rjw57/buri/hardware/README.md

# Buri: a simple 6502-based computer

This is very much a work in progress repository. It contains schematics, notes,
etc. for a single-board 6502 computer I'm working on.

## Copying

See the [LICENSE](LICENSE.txt) file in the repository for copying information.
