rjw57/buri/hardware/cpu-board/README.md

# Búri CPU board

This board contains the CPU, RAM and ROM along with a UART. It is the smallest
"standalone" computer which is of actual use within the Búri system.
