rjw57/buri/docs/monitor-board.md

---
priority: 1
layout: page
title: Monitor Board
permalink: /hardware/monitor-board/
categories: hardware
excerpt: >
  The Monitor Board provides facilities for halting the processor, single
  stepping, single cycling and reading/writing from/to memory. It's a relatively
  simple bit of hardware driven by an Arduino.
---

<figure>
  The Búri monitor board implemented on a breadboard.
  <figcaption>The Búri monitor board implemented on a breadboard.</figcaption>
</figure>

TODO
