rjw57/buri/docs/_posts/2016-12-08-v3-uploaded.md

---
layout: post
title: "Version 3 uploaded"
date: 2016-12-08
categories: update
---

The old Búri repo did not reflect the current state of development. I've had a
chance to re-think the approach I was taking and now I've uploaded some details
on the new version.
