rjw57/buri/docs/img/bodge-1.jpg

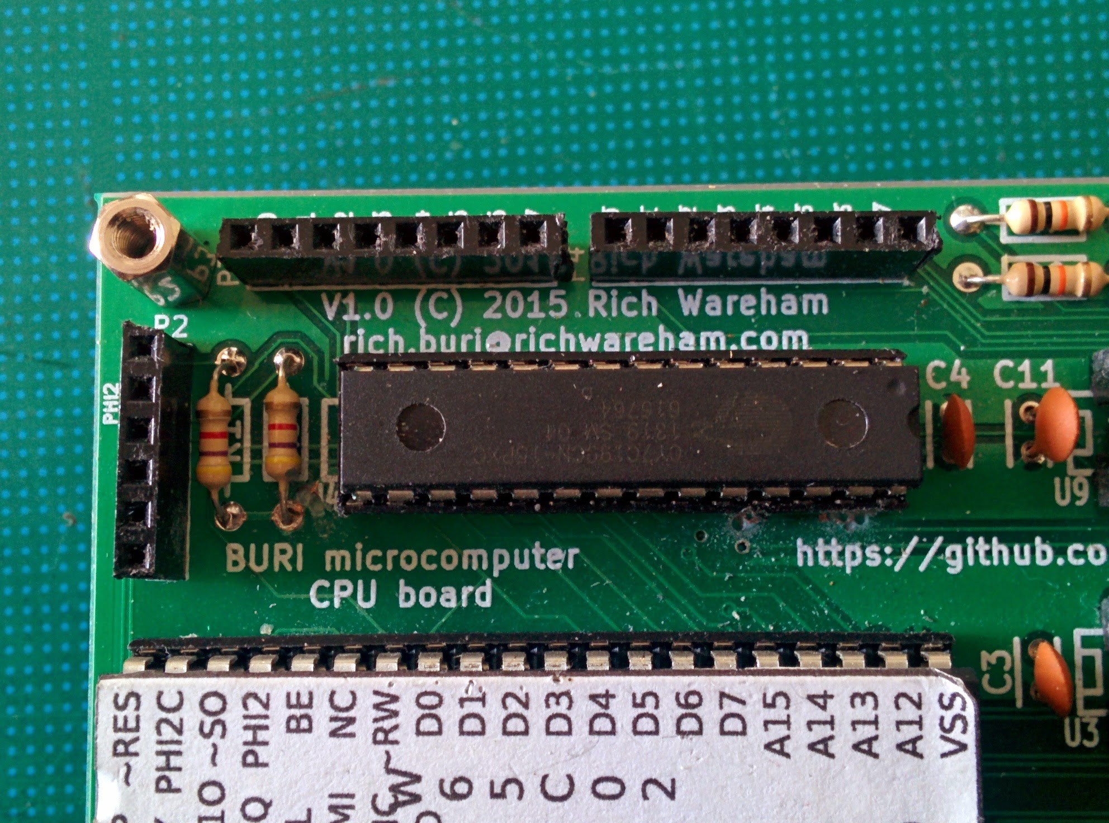
docs/img/bodge-1.jpg
