rjw57/buri/docs/img/bodge-2.jpg

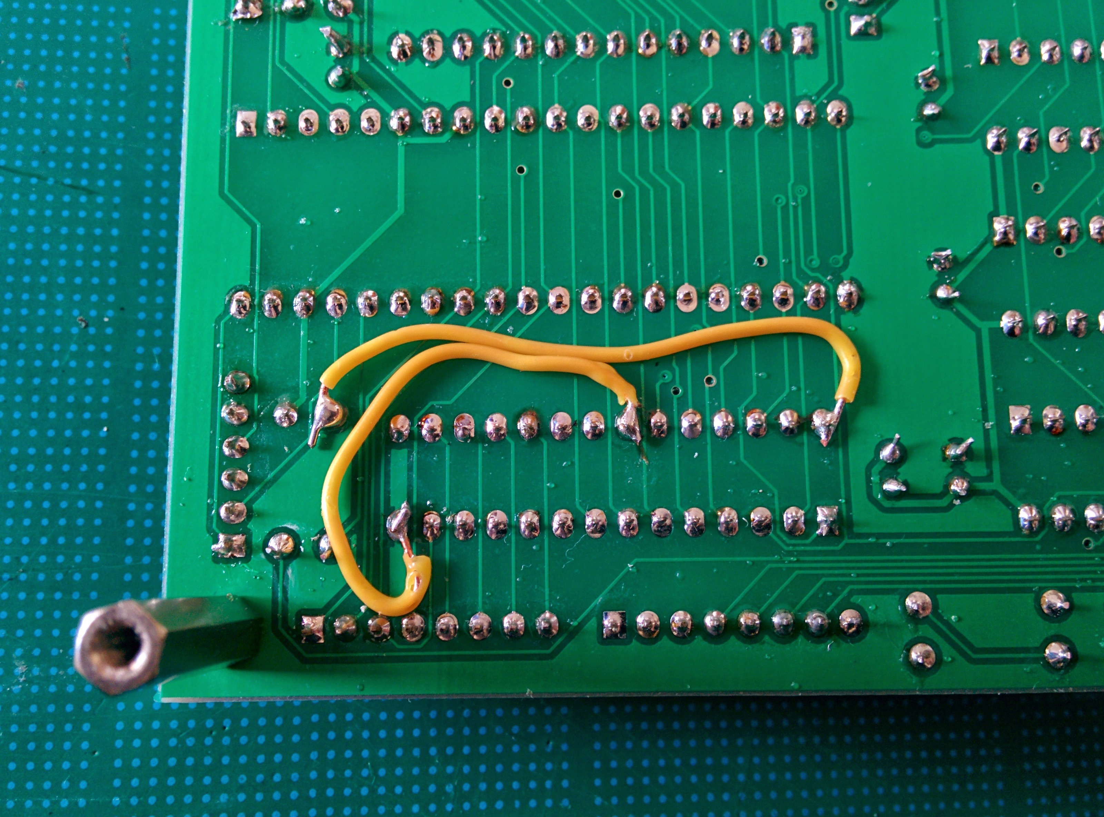
docs/img/bodge-2.jpg
