rjw57/buri/docs/img/cpu-board-3.jpg

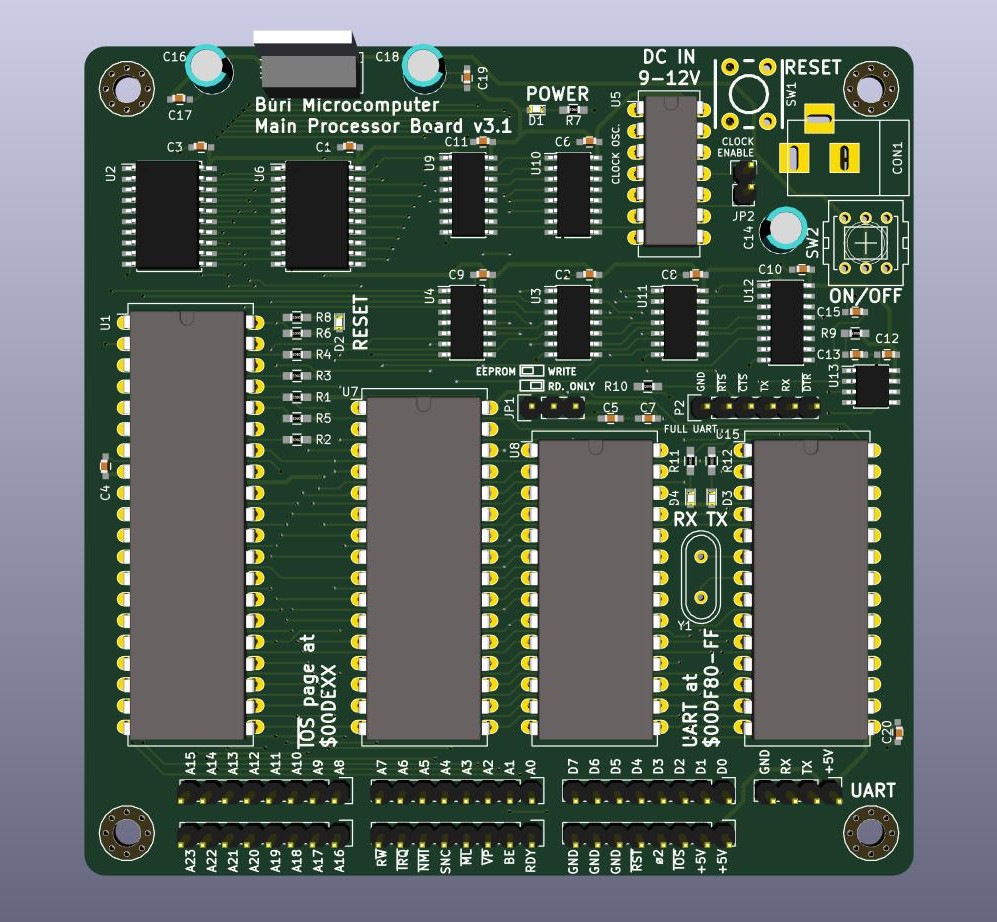
docs/img/cpu-board-3.jpg
