rjw57/buri/docs/img/cpu-board.jpg

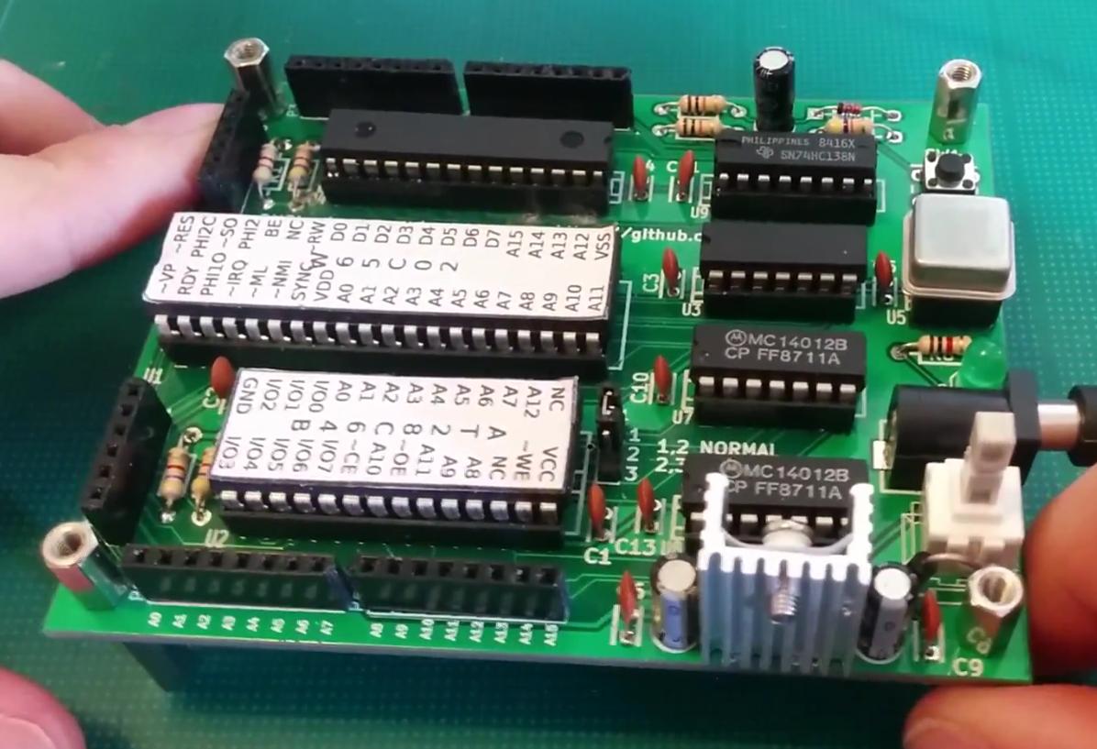
docs/img/cpu-board.jpg
