rjw57/buri/docs/img/lcd-bus-adapter.png

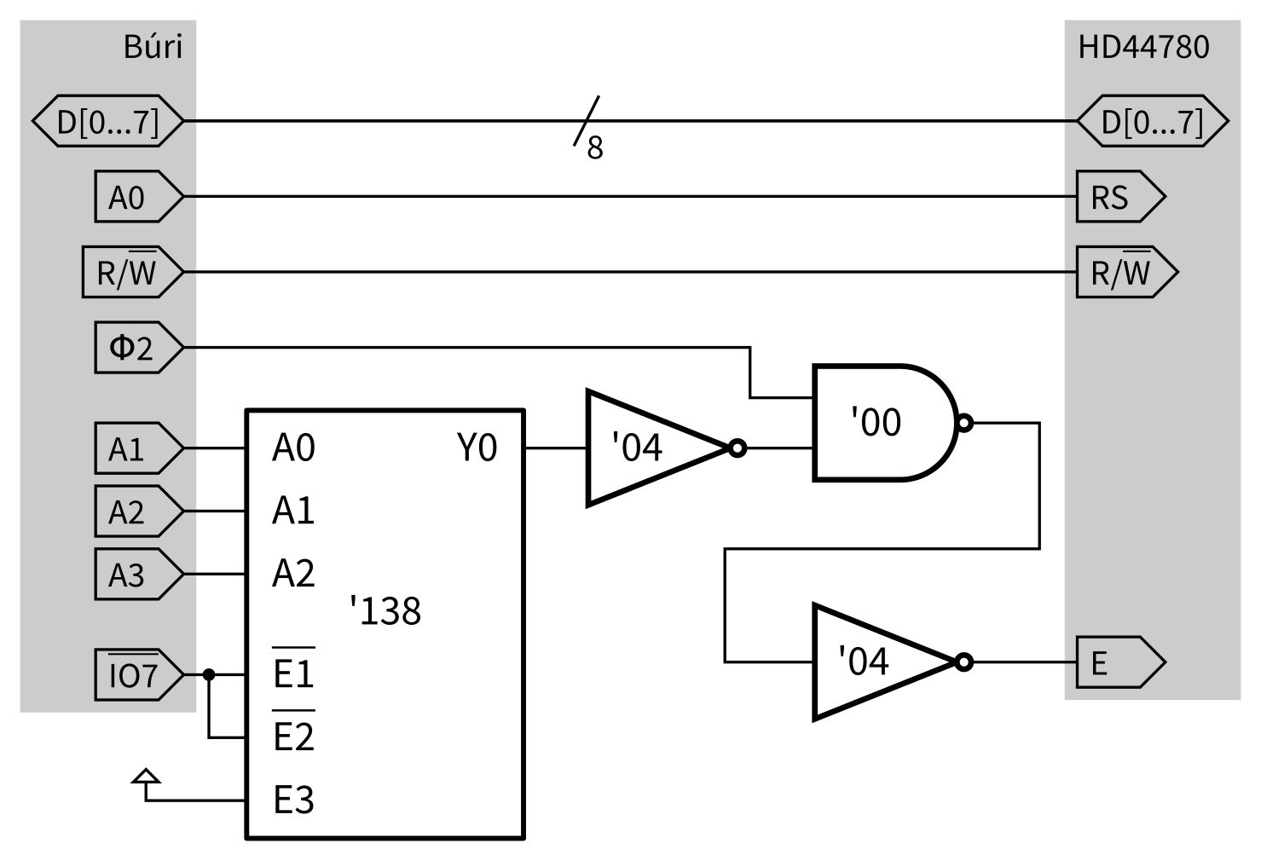
docs/img/lcd-bus-adapter.png
