rjw57/buri/docs/img/lcd-hello.jpg

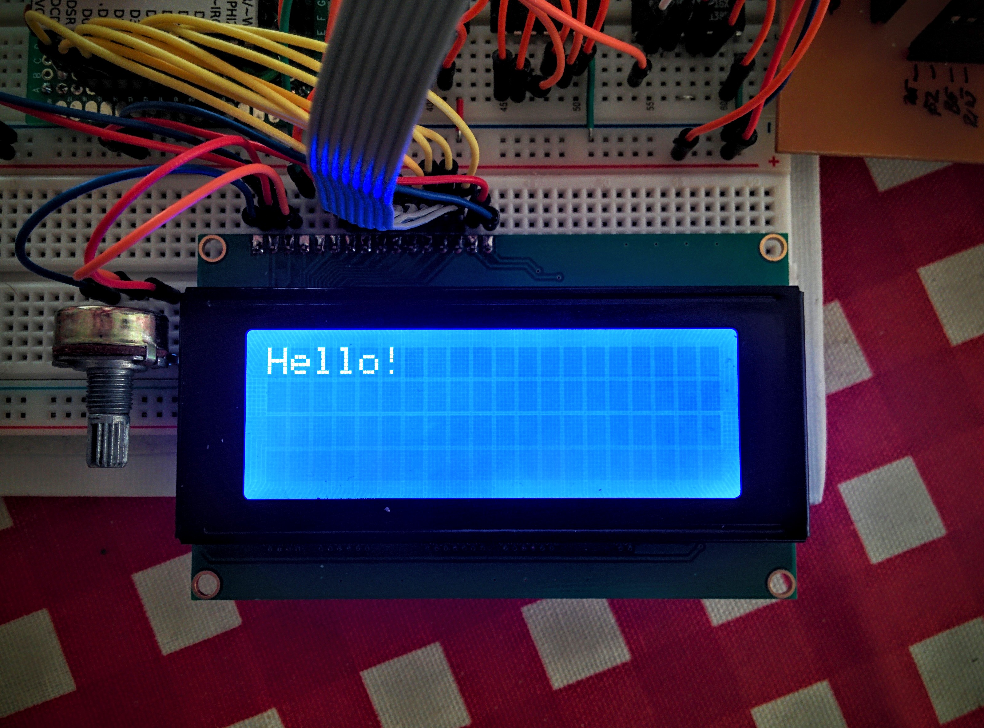
docs/img/lcd-hello.jpg
