rjw57/buri/docs/img/monitor-board.jpg

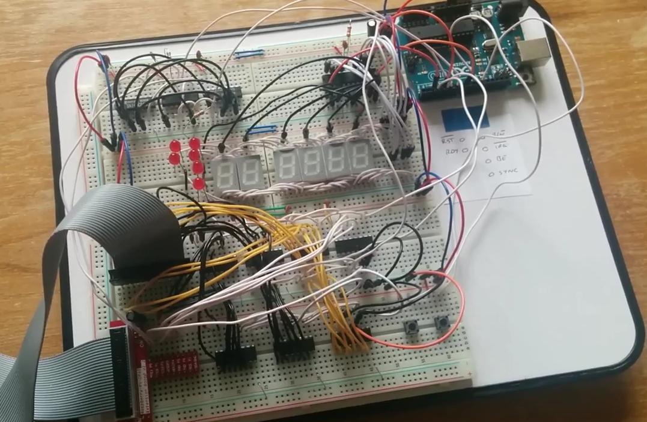
docs/img/monitor-board.jpg
