rjw57/buri/docs/img/serial-port-prototyping.jpg

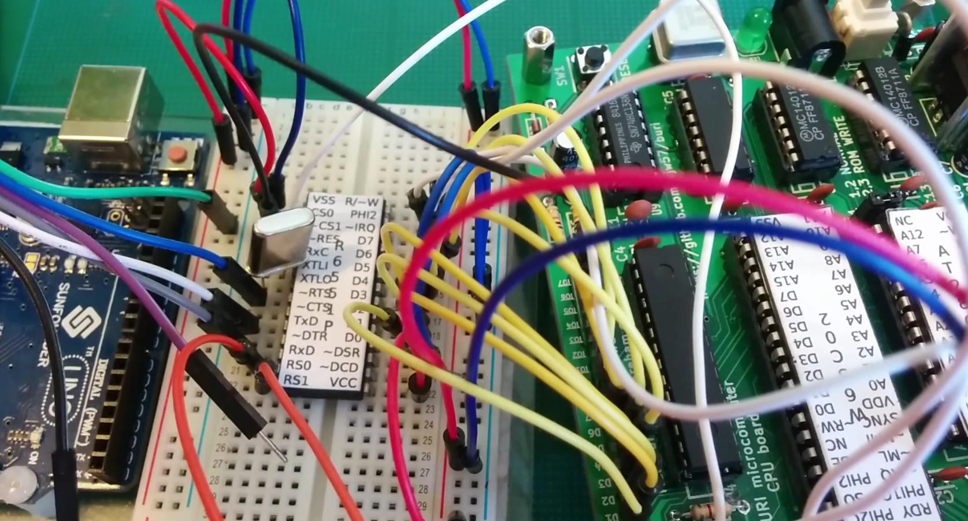
docs/img/serial-port-prototyping.jpg
