rjw57/buri/(threads)

Thread 1 (2016-02-04):

Broken link to sim directory

BigEd, 2016-02-04:
Is https://github.com/rjw57/buri-simulator-python the current simulator? If so, perhaps update the link in the README here?

rjw57, 2016-02-04:
Ah! Thanks, yes. The docs have gotten a bit out of sync.

Fixed in 2caa4544a1e4683c265053cc5f9a26e9466787b4

Closed 2016-02-04.
