rjw57/buri/hardware/cpu-board/plots/cpu-board.pdf

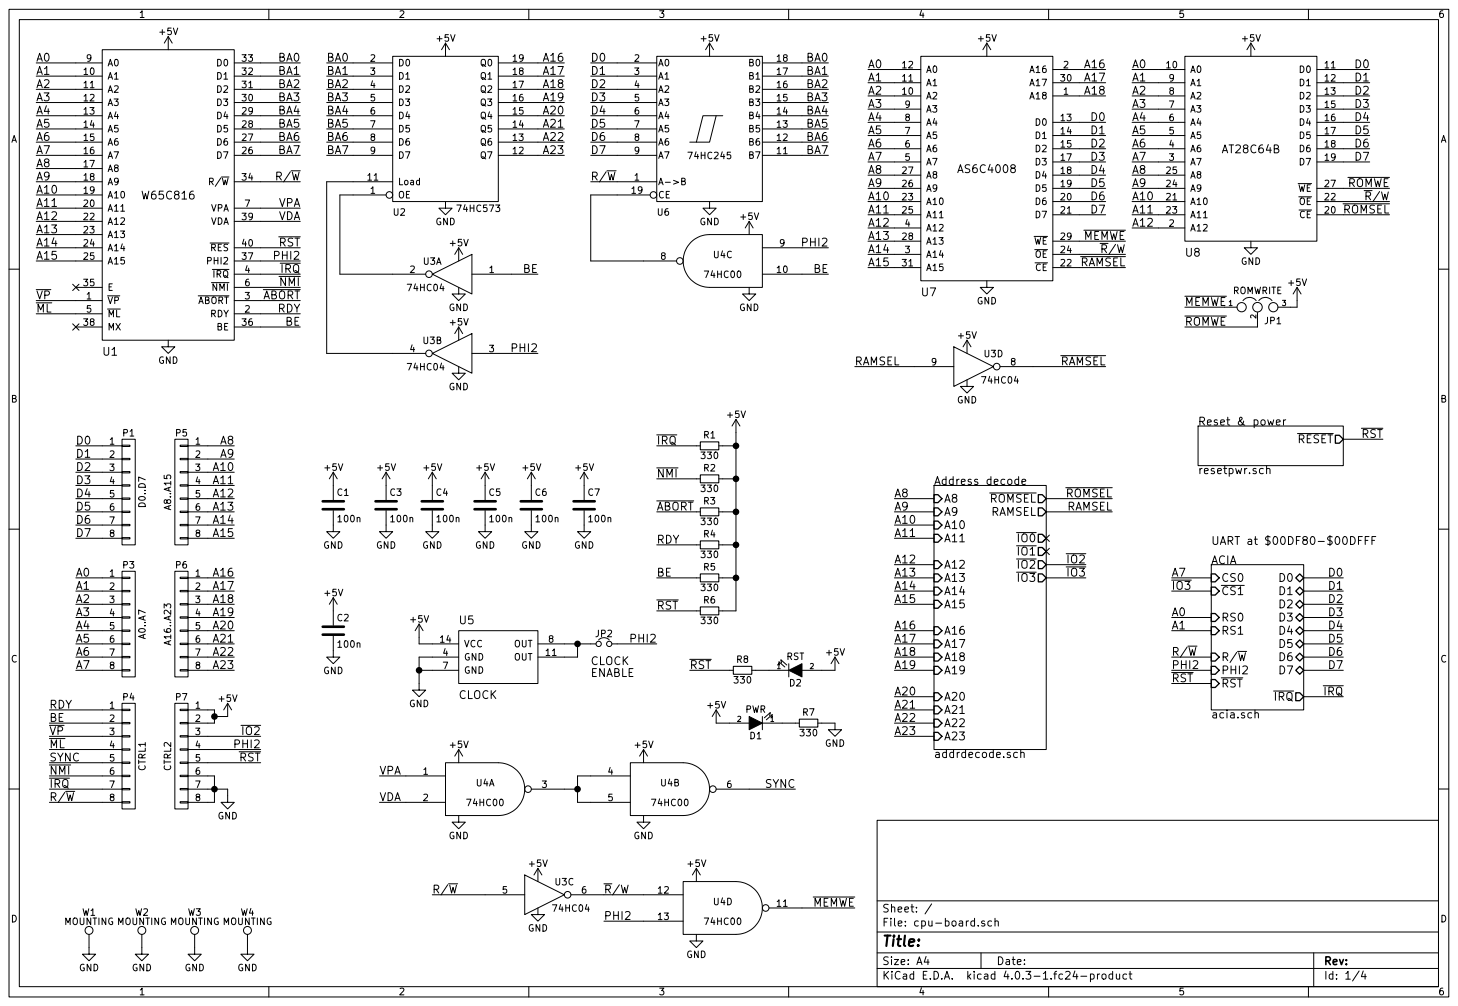
[picture p16: page 1]

UART at $00DF80-$00DFFF Address decode

File: cpu-board.sch Sheet: /
Id: 1/4 Title:

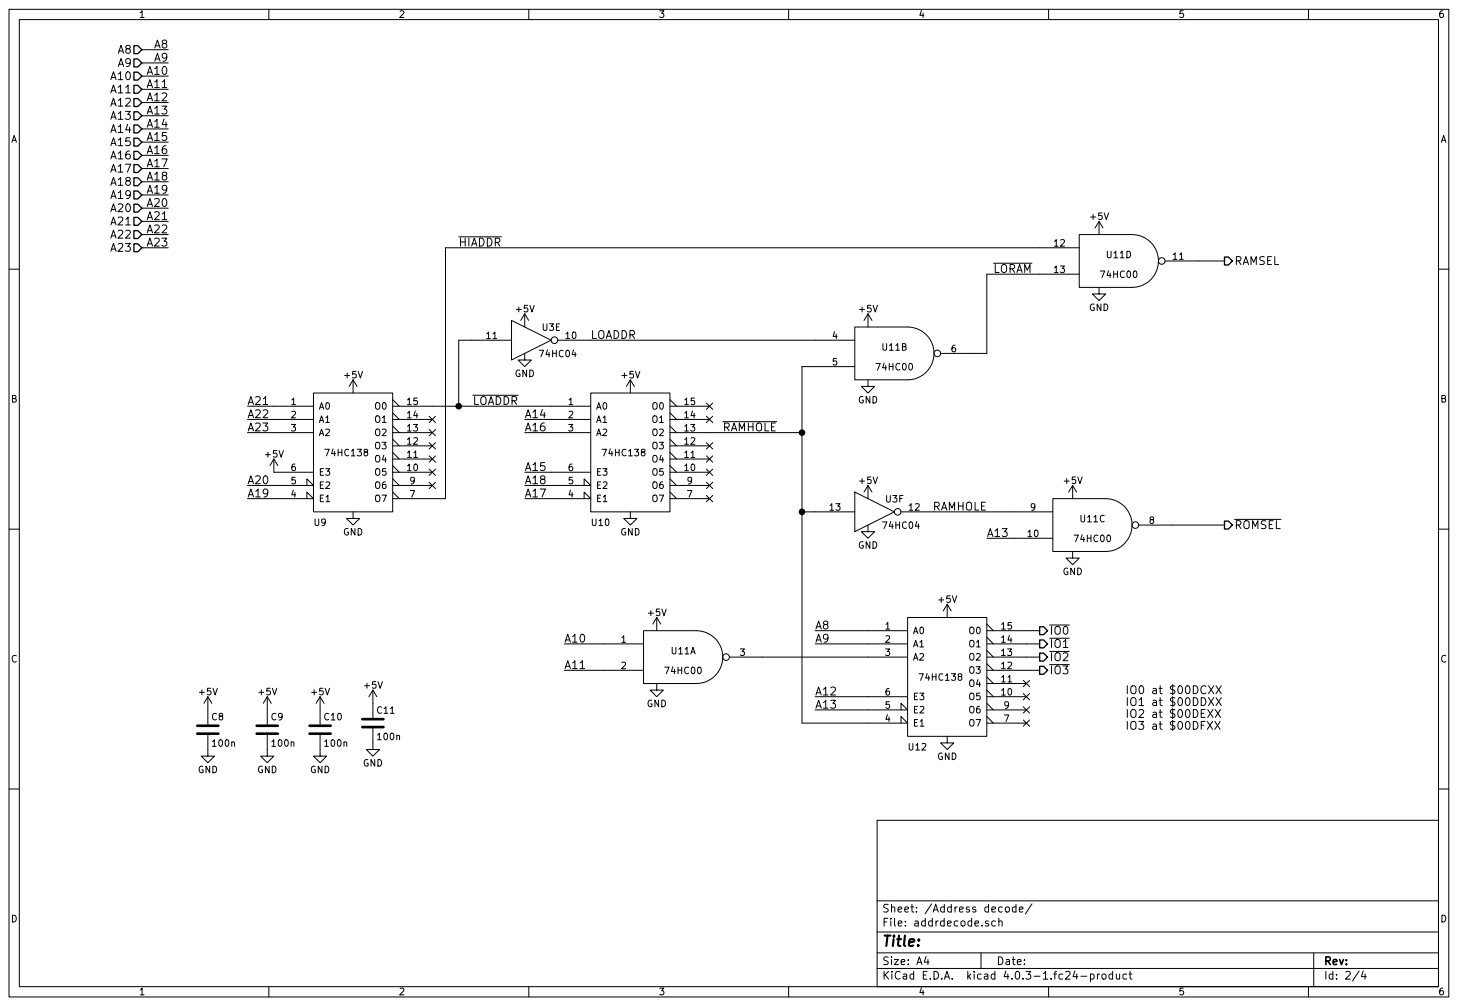
[picture p17: page 2]

Id: 2/4 Title: File: addrdecode.sch Sheet: /Address decode/

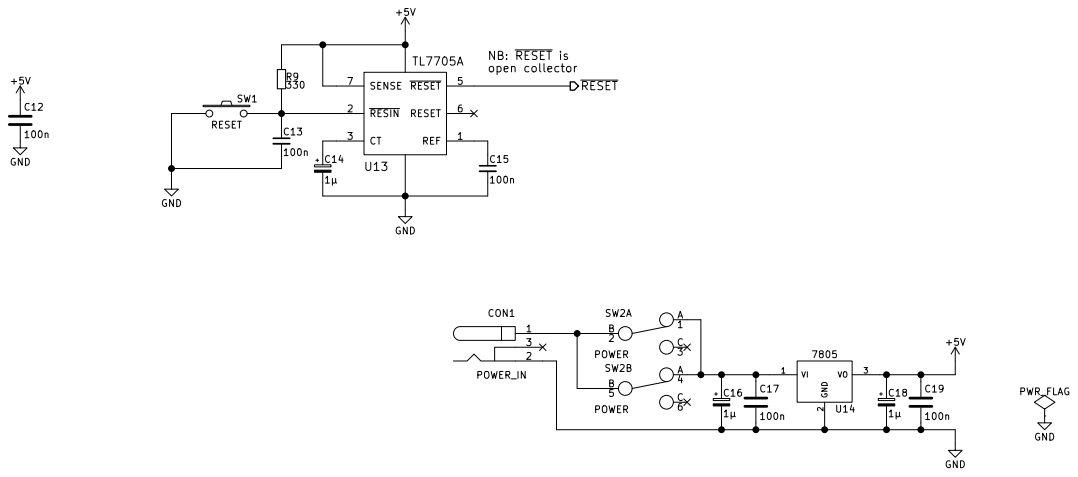
[picture p18: page 3]

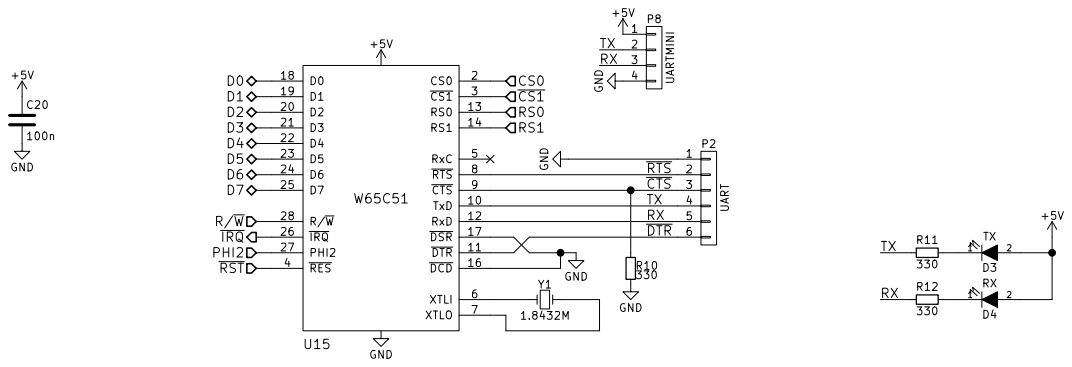
[picture p19: page 4]

Id: 4/4 Title: File: acia.sch Sheet: /ACIA/ GND
