rjw57/buri/hardware/combined/combined.kicad_pcb

## KiCad design hardware/combined/combined.kicad_pcb (2017-01-06)

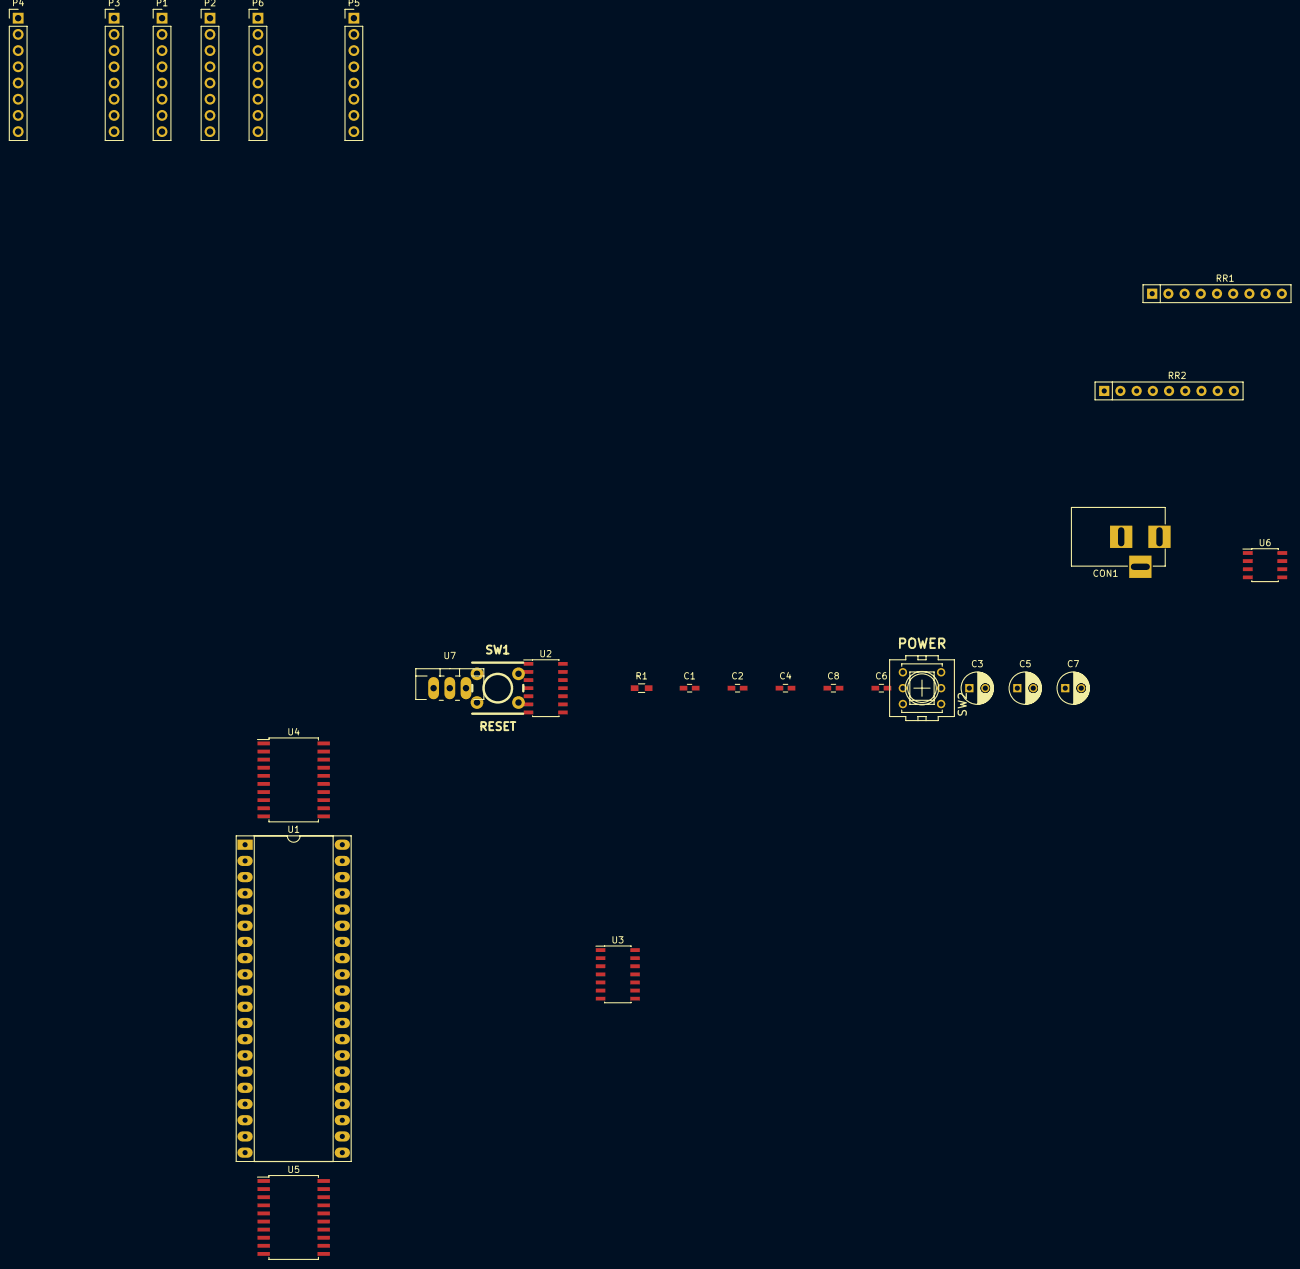
[picture p20: board combined.kicad_pcb from above]

Board: 2 copper layers, 27 parts (0 on the bottom side), 60 nets, no tracks yet.

Parts:
C1, C2, C4, C6, C8: 100n; C_0603_HandSoldering
C3, C5, C7: 1µ; C_Radial_D5_L6_P2.5
CON1: POWER_IN; BARREL_JACK
P1: A0..A7; Pin_Header_Straight_1x08_Pitch2.54mm
P2: A8..A15; Pin_Header_Straight_1x08_Pitch2.54mm
P3: A16..A23; Pin_Header_Straight_1x08_Pitch2.54mm
P4: D0..D7; Pin_Header_Straight_1x08_Pitch2.54mm
P5: CTRL1; Pin_Header_Straight_1x08_Pitch2.54mm
P6: CTRL2; Pin_Header_Straight_1x08_Pitch2.54mm
R1: 330; R_0603_HandSoldering
RR1, RR2: RR8; Resistor_Array_SIP9
SW1: RESET; SW_M6_PTH
SW2: POWER; switch-misc-PVA2R
U1: W65C816; DIP-40_W15.24mm_Socket_LongPads
U2: 74HC04; SOIC-14_3.9x8.7mm_Pitch1.27mm
U3: 74HC00; SOIC-14_3.9x8.7mm_Pitch1.27mm
U4: 74HC245; SOIC-20W_7.5x12.8mm_Pitch1.27mm
U5: 74HC573; SOIC-20W_7.5x12.8mm_Pitch1.27mm
U6: TL7705A; SOIC-8_3.9x4.9mm_Pitch1.27mm
U7: 7805; TO-220_Neutral123_Vertical_LargePads

Connections:
+5V: C1.1, C7.1, C8.1, P6.1, P6.2, R1.1, RR2.1, U1.8, U2.14, U3.14, U4.20, U5.20, U6.7, U6.8, U7.3
/BE: P5.2, RR2.6, U1.36, U2.3, U3.2
/CPU/~ABORT: RR2.5, U1.3
/PHI2: P6.4, U1.37, U2.1, U3.1
/R/~W: P5.8, U1.34, U4.1
/RDY: P5.1, RR2.7, U1.2
/~IRQ: P5.7, RR2.3, U1.4
/~ML: P5.4, U1.5
/~NMI: P5.6, RR2.4, U1.6
/~RST: P6.5, RR2.2, U1.40, U6.5
/~VP: P5.3, U1.1
A0: P1.1, U1.9
A1: P1.2, U1.10
A2: P1.3, U1.11
A3: P1.4, U1.12
A4: P1.5, U1.13
A5: P1.6, U1.14
A6: P1.7, U1.15
A7: P1.8, U1.16
A8: P2.1, U1.17
A9: P2.2, U1.18
A10: P2.3, U1.19
A11: P2.4, U1.20
A12: P2.5, U1.22
A13: P2.6, U1.23
A14: P2.7, U1.24
A15: P2.8, U1.25
A16: P3.1, U5.19
A17: P3.2, U5.18
A18: P3.3, U5.17
A19: P3.4, U5.16
A20: P3.5, U5.15
A21: P3.6, U5.14
A22: P3.7, U5.13
A23: P3.8, U5.12
D0: P4.1, RR1.2, U4.2
D1: P4.2, RR1.3, U4.3
D2: P4.3, RR1.4, U4.4
D3: P4.4, RR1.5, U4.5
D4: P4.5, RR1.6, U4.6
D5: P4.6, RR1.7, U4.7
D6: P4.7, RR1.8, U4.8
D7: P4.8, RR1.9, U4.9
GND: C1.2, C2.2, C3.2, C4.2, C5.2, C6.2, C7.2, C8.2, CON1.2, P5.5, P6.6, P6.7, P6.8, RR1.1, SW1.1, U1.21, U2.7, U3.7, U4.10, U5.10, U6.4, U7.2
unnamed: C2.1, R1.2, SW1.2, U6.2
unnamed: C3.1, U6.3
unnamed: C4.1, U6.1
unnamed: C5.1, C6.1, SW2.1, SW2.4, U7.1
unnamed: CON1.1, SW2.2, SW2.5
unnamed: U1.26, U4.11, U5.9
unnamed: U1.27, U4.12, U5.8
unnamed: U1.28, U4.13, U5.7
unnamed: U1.29, U4.14, U5.6
unnamed: U1.30, U4.15, U5.5
unnamed: U1.31, U4.16, U5.4
unnamed: U1.32, U4.17, U5.3
unnamed: U1.33, U4.18, U5.2
unnamed: U2.2, U5.11
unnamed: U2.4, U5.1
unnamed: U3.3, U4.19
