rjw57/buri/hardware/av-board/av-board.kicad_pcb

## KiCad design hardware/av-board/av-board.kicad_pcb (2016-12-16)

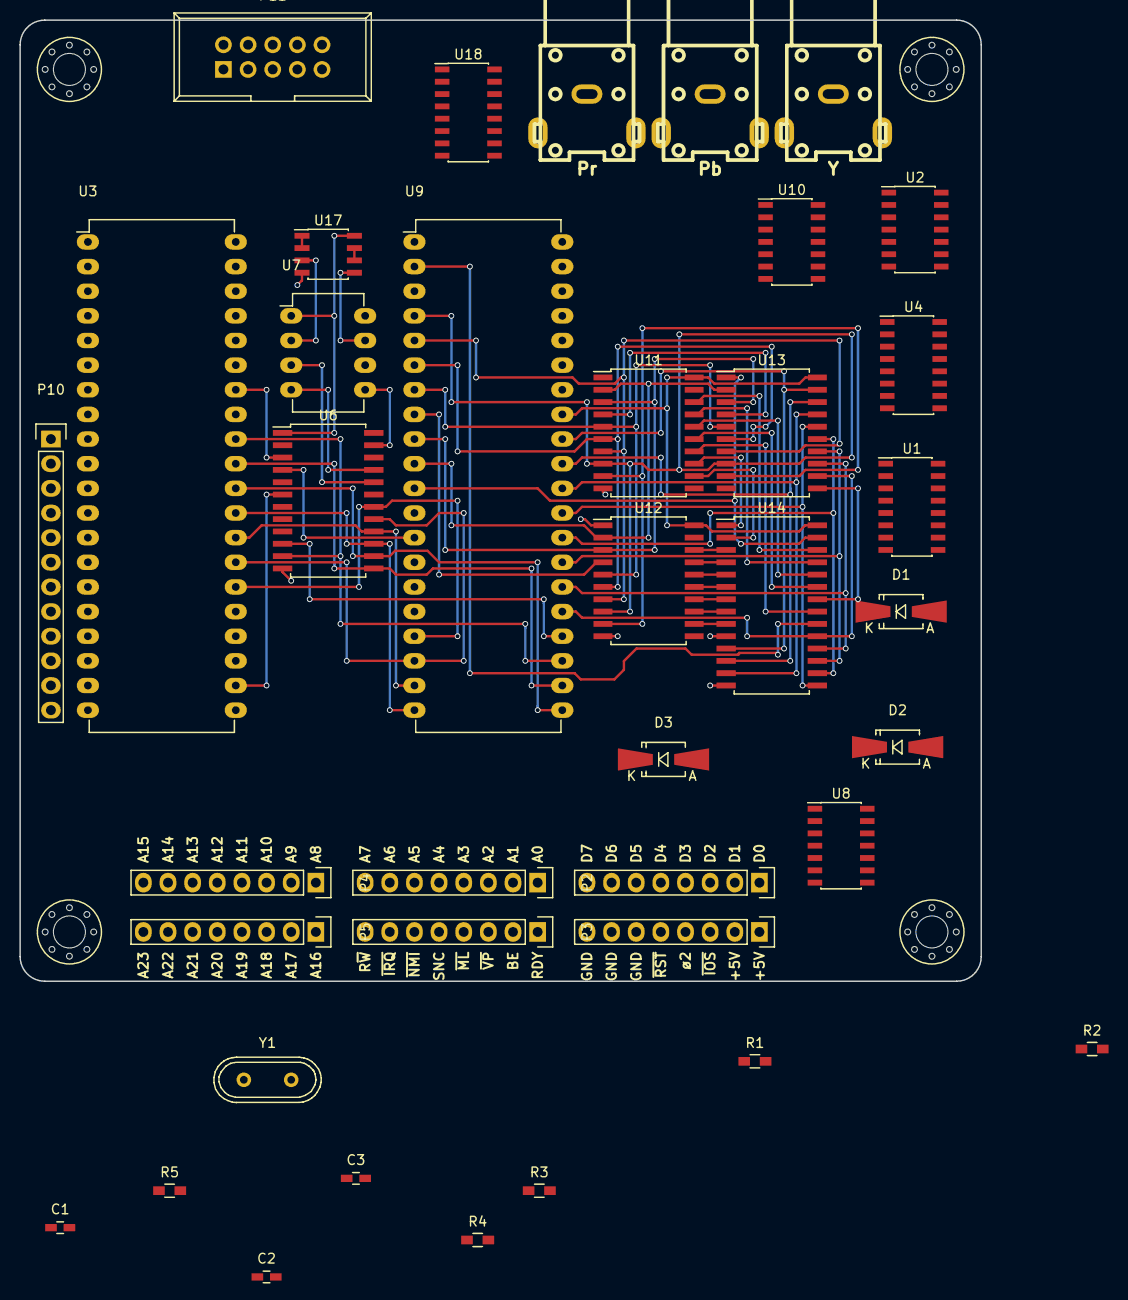
[picture p21: board av-board.kicad_pcb from above]

Board: 2 copper layers, 99.1 x 99.1 mm, 42 parts (0 on the bottom side), 98 nets.

Parts:
C1, C2: 27pF; C_0603_HandSoldering
C3: 100n; C_0603_HandSoldering
D1, D2, D3: D_Small; SMA-SMB_Universal_Handsoldering
P1: D0..D7; Pin_Header_Straight_1x08
P2: A0..A7; Pin_Header_Straight_1x08
P3: CTRL1; Pin_Header_Straight_1x08
P4: A8..A15; Pin_Header_Straight_1x08
P5: A16..A23; Pin_Header_Straight_1x08
P6: CTRL2; Pin_Header_Straight_1x08
P7: Pr; rca_black
P8: Y; rca_black
P9: Pb; rca_black
P10: PARALLEL; Pin_Header_Straight_1x12
P11: KEYBOARD; IDC_Header_Straight_10pins
R1, R2, R3: 330; R_0603_HandSoldering
R4, R5: 1K; R_0603_HandSoldering
U1, U4, U18: 74HC138; SOIC-16_3.9x9.9mm_Pitch1.27mm
U2, U10: 74HC00; SOIC-14_3.9x8.7mm_Pitch1.27mm
U3: WD65C22; DIP-40_W15.24mm_LongPads
U6: YM3812; SOIC-24W_7.5x15.4mm_Pitch1.27mm
U7: YM3014; DIP-8_W7.62mm_LongPads
U8: 74HC04; SOIC-14_3.9x8.7mm_Pitch1.27mm
U9: TMS9929; DIP-40_W15.24mm_LongPads
U11, U12, U13: 74LS574; SOIC-20W_7.5x12.8mm_Pitch1.27mm
U14: CY62256; SOIC-28W_7.5x17.9mm_Pitch1.27mm
U17: TL072; SOIC-8_3.9x4.9mm_Pitch1.27mm
W1, W2, W3, W4: MOUNTING; M3_MOUNT
Y1: 21.48MHz; Crystal_HC49-U_Vertical

Connections:
+5V: P6.1, P6.2, P10.1, P11.2, U1.6, U1.16, U2.14, U3.20, U3.24, U4.16, U6.1, U7.1, U8.14, U9.33, U10.14, U11.20, U12.20, U13.20, U14.28, U17.8, U18.6, U18.16
/A0: P2.1, U3.38, U6.4, U9.13
/A1: P2.2, U3.37
/A2: P2.3, U3.36, U4.1
/A3: P2.4, U3.35, U4.2
/A4: P2.5, U1.1, U4.3
/A5: P2.6, U1.2, U4.6
/A6: P2.7, U1.3, U2.1
/A7: P2.8, U1.5, U2.2
/D0: P1.1, U3.33, U6.10, U9.24
/D1: P1.2, U3.32, U6.11, U9.23
/D2: P1.3, U3.31, U6.13, U9.22
/D3: P1.4, U3.30, U6.14, U9.21
/D4: P1.5, U3.29, U6.15, U9.20
/D5: P1.6, U3.28, U6.16, U9.19
/D6: P1.7, U3.27, U6.17, U9.18
/D7: P1.8, U3.26, U6.18, U9.17
/PHI2: P6.4, U3.25
/R/~W: P3.8, U3.22, U6.6, U10.12
/SPICLK: P11.3, U3.2
/SPIMISO: P11.1, U3.9
/SPIMOSI: P11.4, U3.3
/Sound/OUT: U17.1, U17.2
/Video/COL: U8.8, U12.11
/Video/SEL: U10.1, U10.13
/Video/VD0: U9.32, U13.19, U14.11
/Video/VD1: U9.31, U13.18, U14.12
/Video/VD2: U9.30, U13.17, U14.13
/Video/VD3: U9.29, U13.16, U14.15
/Video/VD4: U9.28, U13.15, U14.16
/Video/VD5: U9.27, U13.14, U14.17
/Video/VD6: U9.26, U13.13, U14.18
/Video/VD7: U9.25, U13.12, U14.19
/Video/VR/~W: U9.11, U13.1, U14.27
/Video/WR: U13.11, U14.22
/Video/~CAS: U9.2, U14.20
/Video/~CSR: U9.15, U10.11
/Video/~CSW: U9.14, U10.3
/W/~R: U6.5, U10.2
/~IOPAGE: P6.3, U1.4, U4.4
/~IRQ: D1.2, D2.2, D3.2, P3.7
/~RST: P6.5, U3.34, U6.3, U9.34
/~SNDS: U4.14, U6.7
/~SPIIRQ2: P11.9, U3.39
GND: C1.1, C2.1, C3.2, P6.6, P6.7, P6.8, P7.2, P8.2, P9.2, P10.12, P11.6, P11.8, P11.10, R1.2, R2.2, R3.2, U1.8, U2.7, U3.1, U4.8, U6.12, U7.6, U8.7, U9.12, U10.7, U11.1, U11.10, U12.1, U12.10, U13.10, U14.10, U14.14, U17.4, U18.4, U18.5, U18.8
unnamed: C1.2, R4.2, Y1.2
unnamed: C2.2, R5.1, Y1.1
unnamed: C3.1, U7.7, U17.5
unnamed: D1.1, U3.21
unnamed: D2.1, U6.2
unnamed: D3.1, U9.16
unnamed: P7.1, R1.1
unnamed: P8.1, R2.1
unnamed: P9.1, R3.1
unnamed: P10.2, U3.10
unnamed: P10.3, U3.11
unnamed: P10.4, U3.12
unnamed: P10.5, U3.13
unnamed: P10.6, U3.14
unnamed: P10.7, U3.15
unnamed: P10.8, U3.16
unnamed: P10.9, U3.17
unnamed: P10.10, U3.18
unnamed: P10.11, U3.19
unnamed: R4.1, R5.2
unnamed: U1.15, U3.23
unnamed: U2.3, U4.5
unnamed: U6.20, U7.3
unnamed: U6.21, U7.4
unnamed: U6.23, U7.5
unnamed: U8.9, U8.10
unnamed: U9.10, U11.2, U12.2, U13.2
unnamed: U9.9, U11.3, U12.3, U13.3
unnamed: U9.8, U11.4, U12.4, U13.4
unnamed: U9.7, U11.5, U12.5, U13.5
unnamed: U9.6, U11.6, U12.6, U13.6
unnamed: U9.5, U11.7, U12.7, U13.7
unnamed: U9.4, U11.8, U12.8, U13.8
unnamed: U9.3, U11.9, U12.9, U13.9
unnamed: U11.12, U14.2
unnamed: U11.13, U14.1
unnamed: U11.14, U14.21
unnamed: U11.15, U14.23
unnamed: U11.16, U14.24
unnamed: U11.17, U14.25
unnamed: U11.18, U14.26
unnamed: U12.12, U14.9
unnamed: U12.13, U14.8
unnamed: U12.14, U14.7
unnamed: U12.15, U14.6
unnamed: U12.16, U14.5
unnamed: U12.17, U14.4
unnamed: U12.18, U14.3
unnamed: U7.2, U17.3
unnamed: U7.8, U17.6, U17.7
unnamed: U3.4, U18.1
unnamed: U3.5, U18.2
unnamed: U3.6, U18.3
