rjw57/buri/hardware/cpu-board/cpu-board.kicad_pcb

## KiCad design hardware/cpu-board/cpu-board.kicad_pcb (2016-12-08)

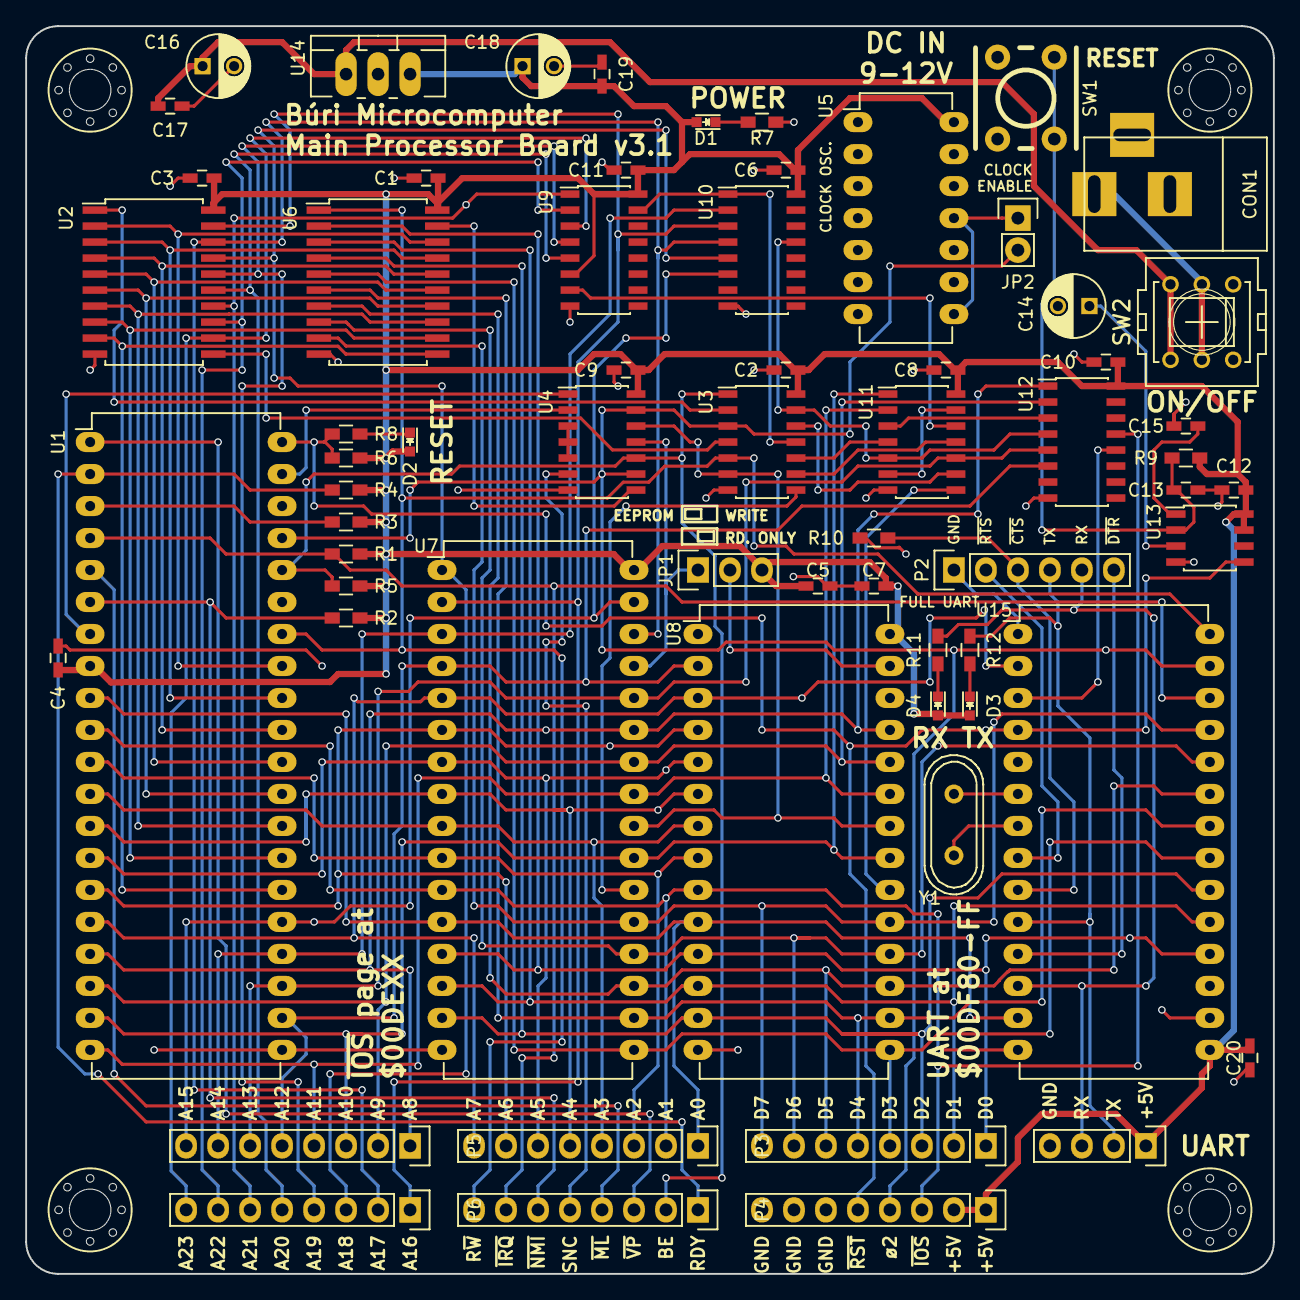
[picture p22: board cpu-board.kicad_pcb from above]

Board: 2 copper layers, 99.1 x 99.1 mm, 69 parts (0 on the bottom side), 91 nets.

Parts:
C1, C2, C3, C4, C5, C6, C7, C8, C9, C10, C11, C12, C13, C15, C17, C19, C20: 100n; C_0603_HandSoldering
C14, C16, C18: 1µ; C_Radial_D5_L6_P2.5
CON1: POWER_IN; BARREL_JACK
D1: PWR; LED_0603
D2: RST; LED_0603
D3: TX; LED_0603
D4: RX; LED_0603
JP1: ROMWRITE; Pin_Header_Straight_1x03
JP2: Jumper_NC_Small; Pin_Header_Straight_1x02
P1: D0..D7; Pin_Header_Straight_1x08
P2: UART; Pin_Header_Straight_1x06
P3: A0..A7; Pin_Header_Straight_1x08
P4: CTRL1; Pin_Header_Straight_1x08
P5: A8..A15; Pin_Header_Straight_1x08
P6: A16..A23; Pin_Header_Straight_1x08
P7: CTRL2; Pin_Header_Straight_1x08
P8: UARTMINI; Pin_Header_Straight_1x04
R1, R2, R3, R4, R5, R6, R7, R8, R9, R10, R11, R12: 330; R_0603_HandSoldering
SW1: RESET; SW_M6_PTH
SW2: ON/OFF; switch-misc-PVA2R
U1: W65C816; DIP-40_W15.24mm_LongPads
U2: 74HC573; SOIC-20_7.5x12.8mm_Pitch1.27mm
U3: 74HC04; SOIC-14_3.9x8.7mm_Pitch1.27mm
U4, U11: 74HC00; SOIC-14_3.9x8.7mm_Pitch1.27mm
U5: CLOCK; DIP-14_W7.62mm_LongPads
U6: 74HC245; SOIC-20_7.5x12.8mm_Pitch1.27mm
U7: AS6C4008; DIP-32_W15.24mm_LongPads
U8: AT28C64B; DIP-28_W15.24mm_LongPads
U9, U10, U12: 74HC138; SOIC-16_3.9x9.9mm_Pitch1.27mm
U13: TL7705A; SOIC-8_3.9x4.9mm_Pitch1.27mm
U14: 7805; TO-220_Neutral123_Vertical_LargePads
U15: W65C51; DIP-28_W15.24mm_LongPads
W1, W2, W3, W4: MOUNTING; M3_MOUNT
Y1: 1.8432M; Crystal_HC49-U_Vertical

Connections:
+5V: C1.1, C2.1, C3.1, C4.1, C5.1, C6.1, C7.1, C8.1, C9.1, C10.1, C11.1, C12.1, C18.1, C19.1, C20.1, D1.2, D2.2, D3.2, D4.2, JP1.3, P7.1, P7.2, P8.1, R1.1, R2.1, R3.1, R4.1, R5.1, R6.1, R9.1, U1.8, U2.20, U3.14, U4.14, U5.14, U6.20, U7.32, U8.28, U9.6, U9.16, U10.16, U11.14, U12.16, U13.7, U13.8, U14.3, U15.15
/A2: P3.3, U1.11, U7.10, U8.8
/A3: P3.4, U1.12, U7.9, U8.7
/A4: P3.5, U1.13, U7.8, U8.6
/A5: P3.6, U1.14, U7.7, U8.5
/A6: P3.7, U1.15, U7.6, U8.4
/ACIA/CS0: P3.8, U1.16, U7.5, U8.3, U15.2
/ACIA/D0: P1.1, U6.2, U7.13, U8.11, U15.18
/ACIA/D1: P1.2, U6.3, U7.14, U8.12, U15.19
/ACIA/D2: P1.3, U6.4, U7.15, U8.13, U15.20
/ACIA/D3: P1.4, U6.5, U7.17, U8.15, U15.21
/ACIA/D4: P1.5, U6.6, U7.18, U8.16, U15.22
/ACIA/D5: P1.6, U6.7, U7.19, U8.17, U15.23
/ACIA/D6: P1.7, U6.8, U7.20, U8.18, U15.24
/ACIA/D7: P1.8, U6.9, U7.21, U8.19, U15.25
/ACIA/PHI2: JP2.2, P7.4, U1.37, U3.3, U4.9, U4.13, U15.27
/ACIA/R/~W: P4.8, U1.34, U3.5, U6.1, U15.28
/ACIA/RS0: P3.1, U1.9, U7.12, U8.10, U15.13
/ACIA/RS1: P3.2, U1.10, U7.11, U8.9, U15.14
/ACIA/RX: P2.5, P8.3, R12.2, U15.12
/ACIA/TX: P2.4, P8.2, R11.2, U15.10
/ACIA/~CS1: U12.12, U15.3
/ACIA/~CTS: P2.3, R10.1, U15.9
/ACIA/~DTR: P2.6, U15.11
/ACIA/~IRQ: P4.7, R1.2, U1.4, U15.26
/ACIA/~RTS: P2.2, U15.8
/Address decode/A8: P5.1, U1.17, U7.27, U8.25, U12.1
/Address decode/A9: P5.2, U1.18, U7.26, U8.24, U12.2
/Address decode/A10: P5.3, U1.19, U7.23, U8.21, U11.1
/Address decode/A11: P5.4, U1.20, U7.25, U8.23, U11.2
/Address decode/A12: P5.5, U1.22, U7.4, U8.2, U12.6
/Address decode/A13: P5.6, U1.23, U7.28, U11.10, U12.5
/Address decode/A14: P5.7, U1.24, U7.3, U10.2
/Address decode/A15: P5.8, U1.25, U7.31, U10.6
/Address decode/A16: P6.1, U2.19, U7.2, U10.3
/Address decode/A17: P6.2, U2.18, U7.30, U10.4
/Address decode/A18: P6.3, U2.17, U7.1, U10.5
/Address decode/A19: P6.4, U2.16, U9.4
/Address decode/A20: P6.5, U2.15, U9.5
/Address decode/A21: P6.6, U2.14, U9.1
/Address decode/A22: P6.7, U2.13, U9.2
/Address decode/A23: P6.8, U2.12, U9.3
/Address decode/LOADDR: U3.10, U11.4
/Address decode/RAMHOLE: U3.12, U11.9
/Address decode/RAMSEL: U3.9, U11.11
/Address decode/~HIADDR: U9.7, U11.12
/Address decode/~IO2: P7.3, U12.13
/Address decode/~LOADDR: U3.11, U9.15, U10.1
/Address decode/~LORAM: U11.6, U11.13
/Address decode/~RAMHOLE: U3.13, U10.13, U11.5, U12.4
/Address decode/~ROMSEL: U8.20, U11.8
/BA0: U1.33, U2.2, U6.18
/BA1: U1.32, U2.3, U6.17
/BA2: U1.31, U2.4, U6.16
/BA3: U1.30, U2.5, U6.15
/BA4: U1.29, U2.6, U6.14
/BA5: U1.28, U2.7, U6.13
/BA6: U1.27, U2.8, U6.12
/BA7: U1.26, U2.9, U6.11
/BE: P4.2, R5.2, U1.36, U3.1, U4.10
/RDY: P4.1, R4.2, U1.2
/Reset & power/~RESET: P7.5, R6.2, R8.2, U1.40, U13.5, U15.4
/SYNC: P4.5, U4.6
/VDA: U1.39, U4.2
/VPA: U1.7, U4.1
/~ABORT: R3.2, U1.3
/~MEMWE: JP1.1, U4.11, U7.29
/~ML: P4.4, U1.5
/~NMI: P4.6, R2.2, U1.6
/~RAMSEL: U3.8, U7.22
/~ROMWE: JP1.2, U8.27
/~R~/W: U3.6, U4.12, U7.24, U8.22
/~VP: P4.3, U1.1
GND: C1.2, C2.2, C3.2, C4.2, C5.2, C6.2, C7.2, C8.2, C9.2, C10.2, C11.2, C12.2, C13.2, C14.2, C15.2, C16.2, C17.2, C18.2, C19.2, C20.2, CON1.2, P2.1, P7.6, P7.7, P7.8, P8.4, R7.1, R10.2, SW1.1, U1.21, U2.10, U3.7, U4.7, U5.4, U5.7, U6.10, U7.16, U8.14, U9.8, U10.8, U11.7, U12.8, U13.4, U14.2, U15.1, U15.16, U15.17
unnamed: C13.1, R9.2, SW1.2, U13.2
unnamed: C14.1, U13.3
unnamed: C15.1, U13.1
unnamed: C16.1, C17.1, SW2.1, SW2.4, U14.1
unnamed: CON1.1, SW2.2, SW2.5
unnamed: D1.1, R7.2
unnamed: D2.1, R8.1
unnamed: D3.1, R11.1
unnamed: D4.1, R12.1
unnamed: JP2.1, U5.8, U5.11
unnamed: U2.1, U3.2
unnamed: U2.11, U3.4
unnamed: U4.3, U4.4, U4.5
unnamed: U4.8, U6.19
unnamed: U11.3, U12.3
unnamed: U15.6, Y1.1
unnamed: U15.7, Y1.2
