rjw57/buri/(commit log)

2014-11-27 fix bus placement on CPU
    [mk1.sch]
2014-11-27 tidy up schematic
    [mk1.sch]
2014-11-27 fix memory map for ROM
    [mk1.sch]
2014-11-28 fix address and ICP logic
    [mk1.sch]
2014-11-28 move to using R/~W for ~WE
    [mk1.sch]
2014-11-28 tidy up layout a lot
    [mk1.sch]
2014-11-28 add 7805 regulator
    [mk1.sch]
2014-11-28 add capacitor across external bus VCC/GND
    [mk1.sch]
2014-11-28 rename project to something more meaningful
    [6502-computer.sch]
2014-11-28 stub out a VIA-based IO board
    [6502-computer.sch, io-board.sch]
2014-11-28 ass ginle step and improved ICP
    [6502-computer.sch]
2014-11-30 initial import
    [mk1.cfg]
2014-12-01 differentiate memory map a little more
    [mk1.cfg]
2014-12-01 re-factor build system *again*
    [mk1.cfg]
2014-12-01 renbame mk1.cfg -> rom.cfg
    [rom.cfg]
2014-12-01 port reset vector to assembler
2014-12-10 move compute board into separate directory
    [compute-module-v1.sch, io-board.sch]
2015-01-18 add sense for debounced mode and select switch
2015-01-18 use mode and select switches to advance bus values
2015-01-18 mode button toggles demo mode
2015-01-18 experiment with mode/select button interface
2015-01-20 monitor-firmware.ino: fix typo "swiches" -> "switches"
2015-02-01 ad single cycle circuitry
    [compute-module-v1.sch, single-cycling.sch]
2015-02-03 tweak single-step circuit to use NAND and NOTs
    [compute-module-v1.sch, single-cycling.sch]
2015-02-03 add more sophisticated address decode
    [compute-module-v1.sch, single-cycling.sch]
2015-02-05 add initial draft of monitor board
    [monitor-board.sch, single-cycle.sch]
2015-02-07 re-draft with connectors from breadboard
    [compute-module-v1.sch, reset.sch, single-cycling.sch]
2015-02-07 start to add bus shift reg
    [monitor-board.sch]
2015-02-07 Squashed 'lib/iheart-kicad-lib/' content from commit da1bcf5
    git-subtree-dir: lib/iheart-kicad-lib
    git-subtree-split: da1bcf537bb686f1802663abfd5f4655daa5df3f
2015-02-07 start to design control bus monitor stage
    [monitor-board.sch, single-cycle.sch]
2015-02-07 monitor: move to 74266 shift reg
    [monitor-board.sch, single-cycle.sch]
2015-02-07 re-arrange shift reg on page
    [monitor-board.sch]
2015-02-10 start to add separate input and output registers
    [input-stage.sch, monitor-board.sch, single-cycle.sch]
2015-02-10 monitor: add output stage
    [input-stage.sch, monitor-board.sch, output-stage.sch, single-cycle.sch]
2015-02-12 updte montiro board with display and full input
    [display.sch, input-stage.sch, monitor-board.sch, output-stage.sch, single-cycle.sch]
2015-02-12 don't leave some shift reg inputs floating
    [input-stage.sch]
2015-02-13 set ROM size to 8K
    [rom.cfg]
2015-02-14 rename compute-module-v1 -> cpu-board
    [cpu-board.sch, reset.sch]
2015-02-14 update library name in cpu-board project
2015-02-14 refactor loop() stages into separate functions
2015-02-14 make step aborting more robust
    Keep checking on each step loop whether processor is in a step-friendly
    state and abort if, for example, an external device resets it.
2015-02-14 monitor: update schematic to reflect reality
    [input-stage.sch, monitor-board.sch, single-cycle.sch]
2015-02-14 monitor: correct placement of VCC line on Arduino
    [monitor-board.sch]
2015-02-14 tidy up CPU board schematic
    [cpu-board.sch, reset.sch]
2015-02-14 monitor: add control lines for output stage to schematic
    [monitor-board.sch, output-stage.sch]
2015-02-14 pins.h: add definition for output stage control pins
2015-02-15 add untested implementation of output to monitor board
    [display.sch, input-stage.sch, monitor-board.sch, output-stage.sch, single-cycle.sch]
2015-02-15 add first ability to program EEPROM!
    [cpu-board.sch, reset.sch]
2015-02-19 add PDF schematic
2015-02-19 add re-worked address decode
    [addr-decode.sch, cpu-board.sch, reset.sch]
2015-02-19 add monitore board schmatic
2015-02-22 start to make schematic reflect final PCB
    [addr-decode.sch, cpu-board.sch, reset.sch]
2015-02-22 add first stirings of a PCB
    [cpu-board.kicad_pcb]
2015-02-22 move to biggr PCB for the moment
    [cpu-board.kicad_pcb]
2015-02-24 more PCB fiddles
    [cpu-board.kicad_pcb, cpu-board.sch]
2015-02-24 more layout work
    [cpu-board.kicad_pcb]
2015-02-25 another layout iteration
    [cpu-board.kicad_pcb]
2015-02-27 rename computer -> buri
    [rom.cfg]
2015-02-27 reset: re-enable interrupts after bootstrap
2015-02-27 tidy up simulator thread
2015-02-28 add basic command finding and argument parsing
    Demo this with the "echo" command which just prints the command line
    arguments.
    [rom.cfg]
2015-03-01 add OS jump table to support running custom programs!
    [rom.cfg]
2015-03-01 blink: new example to blink a LED
2015-03-01 add C example
    [buri.cfg]
2015-03-01 restrict size of zero page to user area
    [buri.cfg]
2015-03-01 helloworld: make use of putc symbol
    [buri.cfg]
2015-03-02 buri.cfg: add getc to OS jump table entry
    [buri.cfg]
2015-03-02 examples: use -t none for assembler compilation
2015-03-02 examples: add ZPSAVE segment
    [buri.cfg]
2015-03-02 examples: use -t none when linking assembler files too
2015-03-21 add IO ports to schematic
    [addr-decode.sch, cpu-board.kicad_pcb, cpu-board.sch, io.sch, ports.sch, reset.sch]
2015-03-22 layout agoun
    [cpu-board.kicad_pcb, cpu-board.sch, io.sch]
2015-03-22 finish layout
    [addr-decode.sch, cpu-board.kicad_pcb, cpu-board.sch, ports.sch, reset.sch]
2015-03-26 Squashed 'hardware/lib/KiCad-Libraries/' content from commit 0f7fcab
    git-subtree-dir: hardware/lib/KiCad-Libraries
    git-subtree-split: 0f7fcabf2fdedd2dbf7300c4ca5b8cdbe38c048e
    [ADXL345-SCAD.stl, ADXL345-Wings.stl, ADXL345.scad, Chipkit_Shield_Max32.kicad_pcb, Chipkit_Shield_Max32.sch, Chipkit_Shield_uC.kicad_pcb, Chipkit_Shield_uC.sch, CubeSatKit_StackBoard.kicad_pcb]
2015-03-28 first pcb layout
    [addr-decode.sch, cpu-board.kicad_pcb, cpu-board.sch, ports.sch, reset.sch]
2015-03-28 final version sent to manufacturer
    [cpu-board.kicad_pcb]
2015-04-15 pcb: add label for R/~W connector
    [cpu-board.kicad_pcb]
2015-04-15 pcb: tweak plot options
    [cpu-board.kicad_pcb]
2015-04-15 add v1 plots
    [cpu-board-B_Cu.gbl, cpu-board-B_Mask.gbs, cpu-board-Edge_Cuts.gbr, cpu-board-F_Cu.gtl, cpu-board-F_Mask.gts, cpu-board-F_SilkS.gto, cpu-board-NPTH.drl, cpu-board.drl]
2015-04-15 README: add note on CPU board plots
2015-04-15 add plot of monitor board
2015-04-15 README: add note on monitor board plots
2015-04-15 add gerbv rendered PCB
2015-04-15 re-render monitor board schemtatic
2015-04-15 README: add image of CPU board PCB
2015-04-16 route {put,get}c through OS vectors
    [rom.cfg]
2015-04-16 add first pass at a monitor board adaptor
    [cpu-board-trim.kicad_pcb, monitor-board-bus-adaptor.kicad_pcb, monitor-board-bus-adaptor.sch]
2015-04-16 Squashed 'hardware/lib/ab2tech/' content from commit a4f9a79
    git-subtree-dir: hardware/lib/ab2tech
    git-subtree-split: a4f9a7962981ec82a484156ce139b6d599d2c948
    [AB2_0402_C_50_WINGS3D.stl, AB2_0402_R_WINGS3D.stl, AB2_0603_C_80_WINGS3D.stl, AB2_0603_R_WINGS3D.stl, AB2_0805_C_125_WINGS3D.stl, AB2_0805_C_60_WINGS3D.stl, AB2_0805_C_80_WINGS3D.stl, AB2_0805_LED_WINGS3D.stl]
2015-04-16 correct socket layout on bus adaptor
    [monitor-board-bus-adaptor.kicad_pcb]
2015-04-16 re-factor bus adaptor
    [monitor-board-bus-adaptor.kicad_pcb]
2015-04-17 vectorise calls to put/getc
    [buri.cfg]
2015-04-17 os: remove ROM jumpt table
    [rom.cfg]
2015-04-20 bus adaptor: make layout more home-PCB friendly
    [monitor-board-bus-adaptor.kicad_pcb]
2015-04-21 burisim: add --trace flag
2015-06-08 docs: add image of Búri CPU board
2015-06-09 docs: add monitor board image and better thumbnail dir structure
2015-06-15 os: use interrupts for serial I/O
    Cache the status register in zero page on interupt. Use this cache for reading
    from serial port.
2015-06-16 os: use interrupts to wait for transmit as well as recieve
2015-06-16 add .vimrc to configure syntastic
    It's a bit poor form checking in tool-specific configuration but I get tired of
    re-creating this file everywhere.
2015-07-07 add first draft of I/O board
    [io-board.sch]
2015-07-08 io-board: add simple layout for protoboard
    [io-board.kicad_pcb, io-board.sch]
2016-08-08 add fork of Buri OS
    This OS will become to 65816 OS
    [rom.cfg]
2016-08-08 switch to 65816 native mode on reset
2016-08-08 save state & set page register on interrupt
    [rom.cfg]
2016-08-08 tidy up interrupt trampoline setup
    [rom.cfg]
2016-08-09 add BRK-based syscalls
    [rom.cfg]
2016-08-09 tidy up interrupt handlers
2016-08-09 add BRK handling for getc and the like
    This requires re-enabling interrupts at the earliest moment.
2016-09-09 move some of the OS over to being written in C
    This is somewhat experimental but it appears to work.
    [rom.cfg]
2016-11-14 start re-write of OS
    [rom.cfg]
2016-11-15 minimal keyboard driver support
2016-11-16 refactor console driver slightly
2016-11-16 teach console about carriage returns and line feeds
2016-11-17 stub in SPI interface
2016-11-17 send 0xff on all SPI exchanges
2016-11-18 implement data direction for SPI
2016-11-18 SPI bug fixes
2016-11-18 use SPI keyboard within hw/keyboard
2016-11-18 HARDWARE: update description of SPI bus
2016-11-18 remove unused import from spi.s
2016-11-19 do not print high bit ASCII characters
2016-11-19 move scancode decoding to keyboard driver
2016-11-20 add stub sound driver
2016-11-22 disable io by default to serial device
    Since IO waits for serial data to be written, booting with no serial device
    attached leads to deadlocks.
2016-11-23 make spi a bit more efficient
2016-11-23 add idle handler system
    Much like the IRW handler chain there's now an idle handler chain for drivers to
    insert themselves into a subroutine run when nothing else is running. This is
    intended to be a place that "bottom halfs" of IRQ handlers can reside.
2016-11-23 add note on SPI implementation
2016-11-23 use CA2 for keyboard interrupt as it is independent
    Using CA1 had the problem that it was cleared by reading/writing from/to ORA.
    This meant that the spi_{begin,exchange,end} could clear an interrupt we hadn't
    yet handled.
2016-11-24 pertially re-implement SPI for speed
2016-12-08 add v3 hardware
    [acia.sch, addr-decode.sch, addrdecode.sch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]
2016-12-08 remove v1 OS
    [rom.cfg]
2016-12-08 remove outdated examples
    [buri.cfg]
2016-12-08 add details on v3 board
2016-12-12 start to add AV board design
    [av-board.kicad_pcb, av-board.sch]
2016-12-12 add work on VDP board
    [av-board.kicad_pcb, av-board.sch, vdp.sch]
2016-12-15 start to wire up VDP
    [av-board.kicad_pcb, av-board.sch, vdp.sch]
2016-12-15 add first pass at sound wiring
    [av-board.kicad_pcb, av-board.sch, clock.sch, sound.sch, vdp.sch]
2016-12-15 fix capacitor for op amp
    [av-board.sch, clock.sch, sound.sch, vdp.sch]
2016-12-16 add SPI keyboard output
    [av-board.kicad_pcb, av-board.sch, clock.sch, sound.sch, vdp.sch]
2017-01-06 add first stage of combining all hardware together into one PCB
    [combined.kicad_pcb, combined.sch, cpu.sch, resetpwr.sch]
2017-01-06 add buri footprints
