rjw57/buri/(notices)

Notices in the files:
hardware/cpu-board/cpu-board.kicad_pcb:
©2016 Rich Wareham
CC BY-NC-SA 4.0
